LouisMalbranque/Table-Rotative/Réunion du 25 03.docx

Réunion du 25/03 :

Objectifs de la semaine :

Val et Louis :

- Connexion Appli au HC05 ou à l’ESP
- Balancer une trame correcte sans design
- Avancer sur le design

Nous :

- Connecter l’ESP à la place de l’arduino sur le boitier de commande / moteur
- Connexion ESP/ESP
- Envoie le PCB moteur avec la modif ESP
- Vérifier l’optocoupleur ça permet de déclencher : PCB

PCB :

Idée : si on utilise le même PCB pr dvp le projet : récupérer les connecteurs non branchés sur l’ESP et les mettre sur des connecteurs…

Appli :

Tentative de connexion tél -> HC05.
