LouisMalbranque/Table-Rotative/Liste Matériel.docx

Liste Matériel :

- Breadboard
- Ecran LCD
- 1 abaisseur de tension
- 1 NRF
- 1 module Bluetooth
- Relais KY019
- 1 arduino uno + cable
