LouisMalbranque/Table-Rotative/Rapport.docx

Valentin Lupa

Louis Malbranque

Guillaume Vacheron

Alexia Verpoort

Projet M1 S2 :

Amélioration d’une Table Rotative

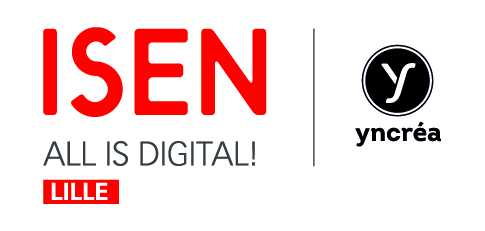
[picture p1: figure]

# Remerciements

Nous souhaitons remercier Nicolas Lissarague, commanditaire du projet, pour ses réponses à nos questions et son aiguillage au cours de ce projet. Et également pour son encadrement tout au long des six semaines.

Enfin, nous remercions Christophe Denoyelle pour la gestion des commandes, et la gestion de la création des PCB.

# Sommaire

# Introduction

Ce projet est une continuation du projet du premier semestre. Monsieur Lissarague avait besoin de finaliser la conception hardware du projet mais il souhaitait également une application mobile pouvant contrôler son projet. Le groupe a été modifié en fonction des volontés de projet du groupe initial. Deux nouveaux membres ont été intégrés au groupe, Louis Malbranque et Guillaume Vacheron, tous deux intéressés par l’aspect très pratique et très utile du projet, le but étant d’avoir un produit fini pouvant être fonctionnel et reproductible.

Le but du projet initial proposé notamment au premier semestre était d’améliorer un système permettant la rotation d’une table sur laquelle repose un objet destiné à la photogrammétrie. Cet objet doit être pris en photo selon plusieurs angles en fonction des arrêts de la table afin de pouvoir par la suite produire une modélisation en 3D de l’objet.

L’objectif principal du projet était donc d’obtenir une table rotative entièrement fonctionnelle dont l’action sur le moteur était commandée directement par une application Android. Il fallait également corriger les problèmes techniques pouvant survenir lors du déroulement et donner des versions finalisées d’un PCB. Ce projet avait donc une priorité sur le résultat.

# Système de base

Le système sur lequel nous avons travaillé est la continuité d’un projet mené au premier semestre : avant d’aborder les différentes améliorations au système, nous allons commencer par expliquer notre base de départ.

NRF24

Appareils photo

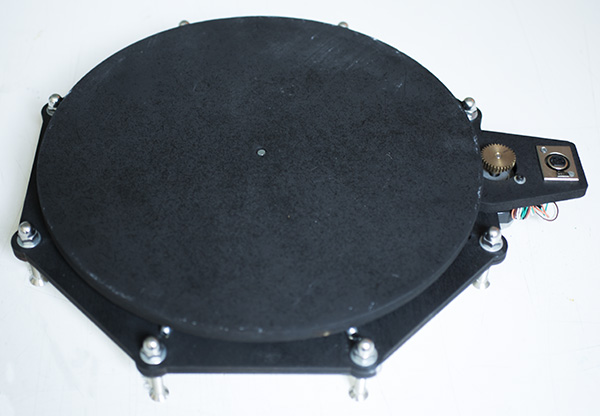
[picture p2: figure]
montage table rotative final
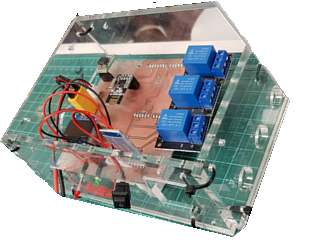
[picture p3: figure]

Communication radio par NRF

[Accélération, Vitesse, Frame,

Steps, Degré, Pause]

PCB moteur

+ moteur

HC05

Relais

LCD

Communication BT par hc05

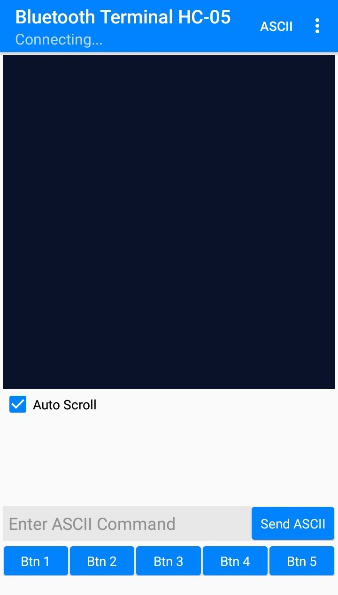
[picture p4: figure]

Accélération, Vitesse, Frame,

Steps, Degré, Pause

Représentation du système de base

Nous sommes donc partis d’un système qui était découpé en 2 parties, une partie boitier de commandes, transmettant les informations aux différents périphériques que ce soit la table elle-même ou les appareils photos, et une partie moteur permettant la réception des données et le contrôle d’un driver moteur sur un moteur pas à pas. Les 2 parties distinctes imposant notamment la présence d’un câble entre le moteur et le boitier de commande.

Au niveau du hardware, chacune des deux parties étaient contrôlées par un Arduino (uno ou nano) et les deux parties pouvaient communiquer entre elles par le biais du module NRF24 par ondes radio. La partie boitier de commande recevait des informations d’une application bluetooth serial communiquant sur le port série de l’Arduino. L’utilisateur transmettait les informations suivantes : l‘accélération voulue pour la rotation du moteur, la vitesse, le nombre de photos à prendre, le nombre de pas moteur, le degré désiré et la durée d’une pause de moteur. Ces données étaient envoyées par bloc et séparées par une virgule. Elles étaient ensuite affichées sur le LCD puis transférée au bloc moteur. Le bloc moteur réalisait alors ses rotations et à chaque pause, renvoyait un signal au bloc commande pour que celui-ci active ses 3 relais en même temps qui permettent de déclencher les appareils photos.

Au niveau du fonctionnement, un seul des 3 relais s’activait, un PCB sur deux était fonctionnel, et le boitier de commande manquait parfois un message du moteur, ce qui empêchait le moteur de s’arrêter définitivement après un tour complet.

# I/ Gestion du projet

Au départ du projet, un échange de mails avait permis d’identifier les premières tâches attendues par Monsieur Lissarague et avait permis de commencer à réfléchir de notre côté sur les potentielles options pouvant être ajoutées. Pour des raisons de méthodologie et d’efficience, le groupe de 4 s’est scindé en deux. Une réunion avait été programmée le lundi 18 mars au matin avec Monsieur Lissarague afin de connaitre ses objectifs ainsi que pour discuter les différents points d’amélioration que nous envisagions.

A la fin de la réunion, en fonction des premiers objectifs donnés, les priorités suivantes ont été déterminées :

F0 (objectifs incontournables) :

- Création d’une application fonctionnelle gérant la connexion par Bluetooth, l’envoi des données par paramétrages et l’envoi des données en temps réel. La différence entre les deux modes étant que le paramétrage ressemble à ce qui existait précédemment avec une rotation dont les pauses dépendent du nombre de photos, et le temps réel étant un mode continu, sans pause, dont la durée dépend de ce que souhaite l’utilisateur.
- Adaptation du code précédent pour pouvoir gérer le temps réel et le paramétrage. (Avant il y avait uniquement le paramétrage).
- Réglage de tous les précédents problèmes de synchronisation pour avoir une table entièrement fonctionnelle.
- Faire des PCB si possible en Chine.

F1 (objectifs nécessaires) :

- Gérer un NEMA23 pour remplacer le précédent moteur qui était un NEMA17 et ainsi permettre l’utilisation de la table pour des objets plus lourds.
- Revoir les composants : remplacer l’arduino par un ESP32 et les relais par des transistors.
- Augmenter le nombre d’appareils photos possibles et ajouter un délai entre le déclenchement de chaque appareil.
- Rajouter des paramètres variables en fonction de la taille du moteur et de la taille de la table afin de connaitre le nombre de pas nécessaires au moteur pour que la table réalise un tour entier.

F2 (objectifs souhaitables) :

- Fonctionnalité magnétoscope c’est-à-dire un déplacement entièrement manuel se présentant sous la forme de plusieurs boutons : avance, recul, avance rapide, recul rapide.
- Réfléchir à un déclenchement infrarouge des appareils photo permettant de ne pas avoir de câbles jack qui relient les appareils photos au boitier de commande.

La réflexion autour de ces différents objectifs nous a alors permis d’élaborer un planning de travail pour les 3 premières semaines, afin de s’assurer de respecter les objectifs initiaux avant de commencer la recherche d’améliorations annexes.

| 18 /03 | 19/03 | 20/03 | 21/03 | 22/03 | 25/03 | 26/03 | 27/03 | 28/03 | 29/03 | 1/04 | 2/04 | 3/04 | 4/04 | 5/04
Modifier le code en orienté objet boitier
Modifier le code en orienté objet du plateau
Application android
Se connecter en Bluetooth avec Android Studio
Mode programmé
Mode temps réel

Planning Binôme Louis/Valentin

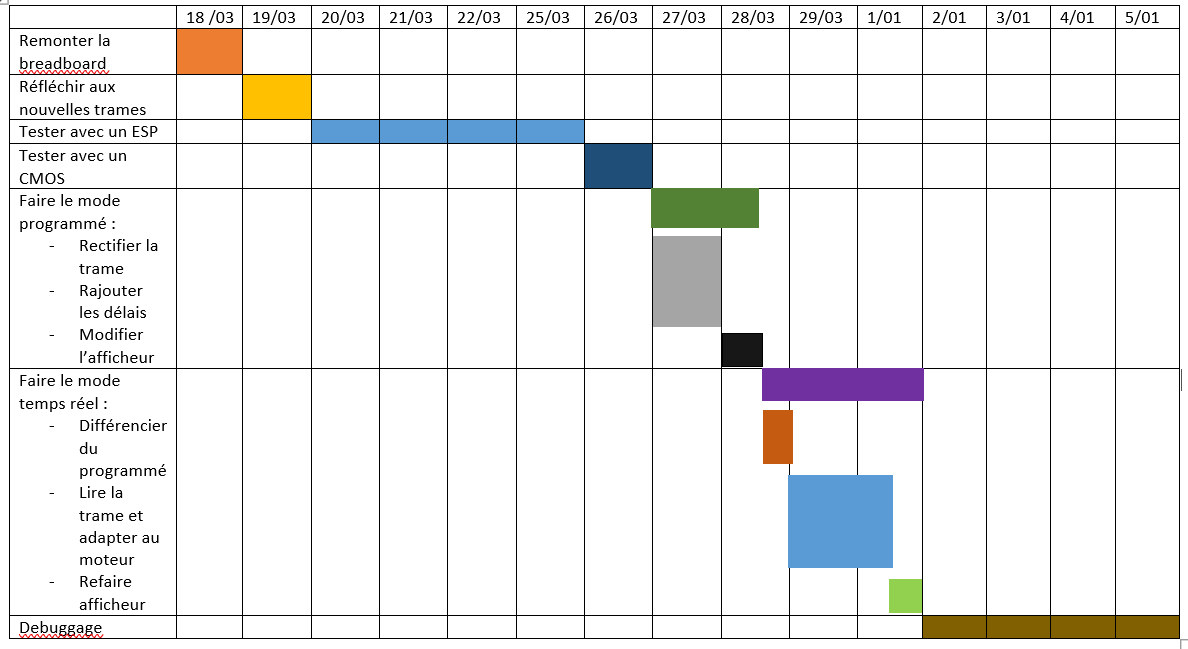
[picture p5: figure]

Planning Binôme Guillaume/Alexia

Cette première esquisse de planning, nous a permis de gérer notre temps au début du projet, nous avons choisi de ne pas se positionner sur les 3 dernières semaines puisque les délais estimés pouvaient être arbitraires, et que les ambitions de fin de projet pouvaient évoluer.

Le planning a été utile pour l’organisation, mais les délais affichés étaient en règle générale assez long, ce qui nous a permis de réfléchir à de potentielles améliorations plus poussées que ce qui était prévu et d’ajouter de nouvelles fonctionnalités suite aux nouvelles discussions avec Monsieur Lissarague.

Concernant l’organisation des réunions et la communication, nous avons choisi de faire un point assez régulier sur les avancées de chacun tous les deux jours, sans oublier l’utilisation des réseaux pour se maintenir au courant en temps réel. La charge de travail pouvait ainsi être répartie plus facilement, afin d’éviter qu’un binôme ou une personne n’ait trop d’objectifs à réaliser en parallèle alors que l’autre binôme avait terminé les siens.

Nous avons également organisé différentes réunions skype avec Monsieur Lissarague, ainsi qu’organisé une réunion physique de mi-projet pour lui faire part de nos avancées et lui faire une démonstration de ce qui était fonctionnel. Cette réunion nous a notamment permis de trouver de nouvelles idées telles que le focus stacking qui sera décrit plus bas. Enfin, les échanges de mail nous ont permis de nous organiser, mais également de clarifier certains points.

# II/ Amélioration de la partie hardware

(SCHEMA BLOC ET SCHEMA ALIMENTATION RAPPORT PREMIER SEMESTRE A REFAIRE)

1) Réflexion autour de l’utilisation d’ESP32 et des transistors

Lors de la première réunion avec Monsieur Lissarague, nous lui avons émis l’idée d’apporter une amélioration supplémentaire au projet afin de supprimer les anciens problèmes de synchronisation qui avaient pu exister au semestre 1. Nous voulions également passer sur microcontrôleur. Afin de maintenir l’accessibilité au code, qui était programmé par l’IDE arduino, et également de simplifier le Hardware, nous avons fait le choix d’utiliser un module de Développement ESP32. L’ESP32 étant un microcontrôleur programmable sous Arduino, le code reste compréhensible pour un habitué des arduino Uno et Nano. L’amélioration majeure apportée par les ESP32 consiste principalement dans l’existence d’une connexion Bluetooth directement intégrée. Notre objectif avec les ESP32 est donc de supprimer les HC05 précédemment présents et également généraliser toute la connexion en mode Bluetooth plutôt que d’avoir un mélange entre connexion par NRF (radio) et HC05.

Afin de gérer la nouvelle connexion, nous avons commencé par adapter la connexion entre une application Android. Le fonctionnement reste identique au HC05, mis à part le nom de la bibliothèque utilisée, les fonctions ayant, elles le même nom, et la logique du code pour obtenir le message ne changeant pas. On a donc une communication Bluetooth qui s’effectue directement sur le Port Série de l’ESP32, le tout étant récupéré caractère par caractère. Le traitement de l’information étant ensuite réalisée en fonction de la trame, il fonctionne en suivant un découpage selon les virgules puis une attribution à chaque variable permettant de contrôler le plateau. Cette étape nous a ainsi permis de supprimer le HC05.

Nous nous sommes ensuite penchés sur le NRF, l’ESP32 et l’utilisation du NRF n’était pas évidente. Premièrement, d’un ESP à l’autre, l’emplacement des Pins permettant la communication, qui est réalisée par SPI, peut varier. Il est ensuite difficile de percevoir l’origine d’une erreur lors de l’utilisation d’un NRF et ceux-ci étant très fragiles, ils peuvent être grillés sans que nous le sachions. Nous avons donc décidé, pour rendre la communication plus homogène et pour utiliser le Bluetooth interne de réaliser une connexion Bluetooth entre les deux ESP32, ce qui permet notamment une meilleure synchronisation.

Nous avons d’abord testé une connexion Bluetooth comme celle qui existe entre un ESP32 et une application Android. Nous nous sommes alors heurtés à un problème qui est que l’ESP32 est considéré comme un module esclave. C’est-à-dire qu’il ne peut pas faire le choix de s’appairer à un autre module Bluetooth mais doit attendre un ordre pour cela. Il n’est donc pas possible, avec le Bluetooth passant par le port série, d’appairer les deux ESP32 car il n’y a pas d’ordre d’appairage envoyé.

Afin de pallier ce problème, nous nous sommes penchés sur une connexion BLE (Bluetooth Low Energy) entre ces deux ESP32. Cette connexion est composée d’un serveur (l’esclave) et d’un client (le maitre). Afin de réaliser cette connexion, nous nous sommes d’abord penchés sur la manière dont les informations pouvaient transiter entre client et serveur. Après quelques recherches, nous avons identifié que le serveur hébergeait en réalité des caractéristiques, qui peuvent prendre la forme d’un string (chaine de caractères) qui lui sont accessibles. La particularité de la communication BLE est que le client, selon l’initialisation du serveur, peut lire ou écrire dans ces caractéristiques.

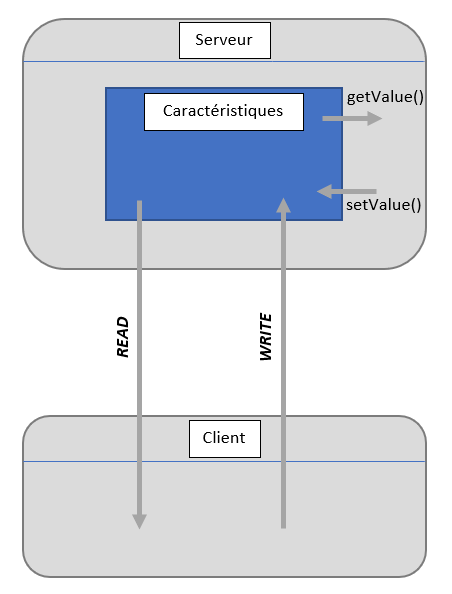
[picture p6: figure]

Nous avons donc adapté ce mode de fonctionnement à notre problème. Plutôt que d’envoyer un tableau de données comme c’était précédemment le cas dans notre NRF, nous avons fait transiter les données à travers la lecture et écriture des caractéristiques du serveur. Le boitier de commande a été programmé comme le maitre, puisque c’est seulement lorsqu’il reçoit une trame de l’application qu’il peut ensuite les transmettre au moteur. Le serveur est donc le plateau. Lorsque le boitier veut transmettre des données, il les écrit directement dans ses caractéristiques, s’il identifie qu’elles ont changé, il peut réaliser un déplacement. Pendant ce temps, le client lit en permanence les caractéristiques pour y apercevoir un signal de fin de déplacement pour déclencher les appareils photos.

Une fois ce mode de communication fonctionnel, nous avons regroupé les deux modes de communications Bluetooth : le programme étant linéaire, l’association des deux n’a pas posé de problème.

Le second changement majeur au niveau du hardware a été le remplacement des relais. Ceux-ci étant trop volumineux, et produisant un bruit à chaque activation, nous avons fait le choix de proposer une nouvelle configuration pour le déclenchement des appareils photo. En premier lieu, nous avons réfléchis à la possibilité de remplacer les relais par des transistors qui est un composant contrôlant le courant ou la tension de sortie en fonction d’une tension qu’on lui applique et qui peut donc être bloquant ou passant.

Après quelques recherches, il nous semblait risqué d’utiliser les transistors pour les appareils photo, nous nous sommes alors orientés vers les optocoupleurs qui sont des composants qui fonctionnent sensiblement de la même manière, qui fournissent donc une tension de sortie en fonction d’une commande. Ces composants étant composé de deux circuits (l’entrée et la sortie) complétement isolés, cela permet de s’assurer qu’aucun courant ne viendra court-circuiter l’appareil photo.

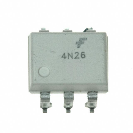
[picture p7: figure]

Nos optocoupleurs fonctionnent donc par intermittence grâce à une pin de commande, qui est mise à l’état haut lorsque l’on souhaite activer un appareil photo, l’optocoupleur est donc capable de fournir une tension de sortie permettant la prise de vue, puis lorsque le pin est remis à l’état bas, l’optocoupleur est de nouveau bloqué et se comporte comme un interrupteur ouvert.

Prise de photo

Pin à 1

Attente

Pin à 0

2) Concept de Focus Stacking

Au vu de l’avancée du projet, il nous a été proposé d’ajouter une nouvelle fonctionnalité au projet : le focus stacking. Ce nouvel élément concerne principalement le déclenchement des appareils photos. Il s’agit d’un mode de fonctionnement qui permet à l’utilisateur de prendre plusieurs photos avec le même appareil photo en modifiant la mise au point entre chaque élément.

Ce qui nous a été proposé est de modifier un système existant permettant grâce à un moteur de pivoter la bague de mise en point afin que le moteur soit commandé par le boitier de commande et que la mise au point à chaque prise de vue se fasse automatiquement. Le fonctionnement général serait donc qu’à chaque arrêt du moteur de la table, les appareils connectés se déclenchent comme précédemment mais qu’avant que la table ne recommence sa rotation, la mise au point soit réglée sur chaque appareil pour une nouvelle photo jusqu’au nombre de photo défini, puis que la mise au point soit remise à son origine pour reprendre la rotation de la table.

Pour cela, nous avons réutilisé le système présent pour le moteur de la table en insérant un ESP32, qui soit un serveur en Bluetooth, et qui pourrait donc recevoir les informations du boitier de commande pour actionner le moteur.

Après discussions, il a été déterminé que chaque appareil photo devait au préalablement pouvoir être réglé manuellement pour obtenir les mises au point voulues avec un maximum de 9 photos par appareil supplémentaire. Ce réglage permettant d’obtenir les différents pas nécessaires que le moteur doit réaliser entre chaque photo sur chaque appareil. Les données devaient ensuite être rentrées dans l’application pour que le boitier de commande puisse envoyer les ordres à chaque moteur d’appareil photo au moment voulu et pour toute la durée de la prise de vue. Ce réglage a été prévu pour être réalisé en pas à pas mais directement sur l’application, grâce à un magnétoscope permettant de faire avancer la bague petit à petit tout en permettant à l’application de calculer directement la valeur de mise au point idéale.

Nous avons pris la décision de déclencher les appareils photos et donc de les brancher directement sur ce module dans le cas où le focus stacking sera utilisé.

3) Modification de la trame d’envoi

Le système de base ne fonctionnait que selon un mode précis qui consistait à prendre un nombre de photos défini durant un tour. Au cours de la présentation des objectifs du projet par Monsieur Lissarague, celui-ci a émis l’idée d’ajouter différentes fonctionnalités et ainsi différents modes. La table rotative devait tout d’abord fonctionner comme lors du projet du premier semestre, c’est-à-dire programmer un nombre de photos à effectuer par un nombre d’appareils photos donnés durant un tour de plateau. Le second mode est en mode continu, la table doit tourner soit pendant un nombre de tours définis soit durant un temps défini. Enfin, une fonctionnalité sous forme de touches de magnétoscopes permettant de bouger comme l’utilisateur le souhaite grâce à des touches d’avance, de recul faisant tourner la table le temps de l’appui ou selon le nombre d’appui de l’utilisateur. Il nous a également fallu ajouter le focus-stacking au fonctionnement de base.

A) Communication Téléphone-Boitier de Commande

Afin de pouvoir intégrer plus facilement les fonctionnalités, un travail sur les trames d’envoi ont été réalisées ainsi que sur les communications. Plusieurs solutions ont été envisagées afin de faciliter la distinction entre modes et également de rendre le code plus ouvert à l’intégration de nouveaux modes.

Au niveau de la communication, nous sommes restés sur un système de trame avec les différentes valeurs séparées par des virgules. Il existe différents MODE qui permettent au boitier de commande s’identifier les différentes trames :

MODE | Utilisation | Explication rapide
0 | Mode programmé | Permet d’effectuer un déplacement sur un tour en réalisant des pauses selon le nombre de photo défini
1 | Mode temps réel | Permet d’effectuer une rotation en fonction d’un nombre de tours ou en temps
3 | Pause | Permet de mettre en pause une action
4 | Arrêt complet | Permet d’arrêter totalement le fonctionnement
5 | Magnéto focus_stacking | Permet de régler le focus en déplaçant le moteur collé à la bague du focus et de retenir les valeurs choisies par l’utilisateur
7 | Connexion aux périphériques | Permet de sélectionner des périphériques avec lequel le boitier de commande va interagir
8 | Paramétrages focus_stacking | Permet d’envoyer les données de tous les appareils photos après réglage grâce au mode 5 pour réaliser une prise de vue avec focus_stacking

Nous allons surtout nous attarder sur les modes 0 et 1 qui sont au cœur de l’utilisation de la table rotative. Pour éviter tout problème de décodage au niveau du boitier de commande, le schéma de la trame envoyé est donc identique en mode temps réel (ou continu) et programmé. L’un des éléments de la trame permet de distinguer si l’on est dans tel ou tel mode.

ID_COMMANDE, MODE, ACCELERATION, VITESSE, NOMBRE_DE_PAS_TABLE, DIRECTION, CHOIX_ROTATION, NOMBRE_DE_TOUR, TEMPS_DE_ROTATION, NOMBRE_DE_PHOTOS, NOMBRE_DE_CAMERAS, PAUSE_ENTRE_CAMERAS, FOCUS_STACKING

Accélération, Vitesse, Nombre_Photos, Nb_Pas_Table, Degré_Désiré, Durée_Pause

Comparaison entre l’ancienne trame et la nouvelle trame

Lors de la récupération de la trame par l’ESP32, tous les éléments de la trame sont récupérés sous forme de String (chaine de caractère) comme représentée ci-dessus. Les éléments sont ensuite récupérés grâce à un découpage selon la virgule et stockés dans un tableau de valeurs. Les valeurs sont ensuite interprétées selon le mode.

La trame est composée des éléments suivants :

-ID_COMMANDE : ID qui est généré automatiquement dans l’application afin de pouvoir différencier plusieurs envois de rotation différents

-MODE : Différence entre les modes pour savoir si l’on est en mode Programmé et Temps Réel

-ACCELERATION, VITESSE : correspondent à la vitesse de la table pendant une rotation et de remise en route après un arrêt.

-NOMBRE_DE_PAS_TABLE correspond au nombre de pas nécessaire pour le moteur pour que la table rotative réalise un tour complet.

-CHOIX_ROTATION : permet de faire une distinction entre le NOMBRE_DE_TOUR et le TEMPS_ROTATION.

-NOMBRE_DE_CAMERAS correspond au nombre de caméras utilisées pour la prise de vue avec un maximum de 9 caméras se déclenchant successivement selon la valeur de PAUSE_ENTRE_CAMERAS durant un arrêt moteur. Le NOMBRE_DE_PHOTOS correspond au nombre de prise de vue (indépendant du nombre d’appareil) au cours d’un tour.

-FOCUS_STACKING : Le nombre de prises de vues avec niveau de focus différents par appareil photo et par arrêt. Il est égal à 0 lorsque le focus_stacking n’est pas désiré.

Lors de la réception des informations par l’application, le boitier de commande crée une liste d’instructions, qui regroupe toutes les instructions qui vont être envoyées aux différents périphériques pour effectuer l’action requise par l’application. La liste d’instruction comporte donc tous les envois de rotation, les prises de photo et permet donc d’avoir une séquence préparée avant toute communication. Chaque instruction ayant un ID spécifique.

B) Communication Boitier de commande-Moteur/périphériques externes

La liste d’instruction ayant été créée, le boitier peut alors communiquer avec les différents périphériques.

Lorsque le boitier de commande a récupéré et décodé la trame (selon le type de MODE 0 ou 1) comme décrit dans le paragraphe précédent, le boitier de commande communique au moteur afin que celui-ci réalise le déplacement souhaité, il peut aussi réaliser les différents réglages nécessaires au focus stacking (décrit en détail dans la partie mode programmé). Nous allons commencer par aborder l’échange uniquement avec le moteur.

La communication se fait par le biais de la communication BLE déjà explicitée. Chaque côté peut lire et écrire dans les caractéristiques du serveur BLE qui est le moteur.

Lorsque le moteur n’effectue aucune action, sa caractéristique est à 0, ce qui permet au boitier de commande de savoir que ce dernier est libre et peut recevoir de nouvelles instructions. En fonction du paramètre MODE reçu par le boitier de commande, deux cas se distinguent dans l’envoi du datagramme :

- Cas Mode temps Réel (MODE à 1)

Dans le cas du temps réel, seuls les paramètres : Accélération, Vitesse, Nombre_de_pas_table, Direction, Choix_Rotation, Nombre_De_Tour et Temps_Rotation, sont utilisées.

L’élément Choix_rotation permet de comprendre si l’utilisateur souhaite réaliser une rotation en continu selon le nombre de tours souhaité (dans ce cas Temps_Rotation ne servira pas) ou selon une durée précise. Il est inutile de préciser le nombre d’appareils photos puisque ce mode est destiné à une prise de vue par caméra par exemple.

Lorsque ce mode est sélectionné, le datagramme écrit dans les caractéristiques du moteur est la suivante :

CHOIX_ROTATION = 0

ACCELERATION, VITESSE, DIRECTION, CHOIX_ROTATION, NOMBRE_DE_TOUR

OU

CHOIX_ROTATION = 1

ACCELERATION, VITESSE, DIRECTION, CHOIX_ROTATION, TEMPS_ROTATION

Les valeurs envoyées TEMPS_ROTATION et NOMBRE_DE_TOUR étant quelque peu modifiées pour permettre d’envoyer une valeur utilisable telle qu’elle par le moteur. Ainsi le TEMPS_ROTATION est multiplié par 1000 pour correspondre à un temps en secondes (auparavant millisecondes) et NOMBRE_DE_TOUR est multiplié par le nombre de pas total de la table.

- Cas Mode Programmé (MODE à 0)

Dans ce pragraphe nous allons aborder la communication du boitier de commande suite à la réception d’un mode 0 mais également aborder les modes 5 et 7 qui peuvent être des antécédents à la réception d’un mode 0 si l’on souhaite effectuer du focus stacking

a) Déplacement du moteur

Dans le cas du mode Programmé, seuls les éléments Accélération, Vitesse, Nombre

De pas table, Direction, Nombre_De_Photos, Nombre_De_Caméras, Pause_entre_Camera sont utilisés.

Lorsque ce mode est sélectionné, la trame envoyée au moteur par bluetooth est la suivante :

ACCELERATION, VITESSE, DIRECTION, 0, NOMBRE_DE_PAS

Ce datagramme ne diffère pas beaucoup de celui du temps réel. Il s’agit en réalité d’un cas particulier dans lequel CHOIX_ROTATION = 0. Ce qui explique la 4ème valeur qui permet de forcer la lecture par le moteur d’un cas de rotation en fonction d’un nombre de pas à effectuer.

Concernant le nouveau paramètre NOMBRE_DE_PAS, celui-ci est un calcul entre le nombre de photos et le nombre de pas total pour effectuer un tour complet de la table. Il s’agit donc du nombre de pas entre chaque déclenchement.

b) Action sur les périphériques – application au focus_stacking

Le boitier de commande ne communique pas uniquement avec le moteur, il peut également communiquer avec les appareils photo ou les mécanismes de focus_stacking définis par l’utilisateur et envoyé grâce au mode 7 dans la communication Application-Boitier de commande.

Ces périphériques ne sont actionnés que dans le cas du mode programmé. Concernant les appareils photo, lorsque le boitier de commande identifie la fin d’une rotation du moteur, il déclenche les appareils photo. Le déclenchement des appareils photo a été géré comme si les optocoupleurs étaient eux-mêmes des périphériques bluetooth afin de garder de la cohérence. On fonctionne donc grâce à un système de thread (ou fil d’exécution) qui est la ligne de conduite du programme et deux threads peuvent être en parallèle donc l’esp32 peut gérer deux processus en même temps. Le processus principal envoie donc au processus secondaire une chaine commune dont le fonctionnement est identique aux caractéristiques d’un serveur BLE.

Prise de photo

Mise à 1 optocoupleur sur le boitier de commande

Nb photos

Boitier de commande

Moteur

Arrêté

Autant de déclenchement successif pour des optocoupleurs différents que de photos voulues

Représentation simplifiée d’une prise de photo sans focus stacking

Le déclenchement des appareils photo par rapport à une configuration en focus stacking se fait directement sur le module du focus stacking et nécessite de s’attarder sur les modes 5 et 7 qui sont reçus par le boitier de commande avec le mode 0. Tout d’abord le boitier recevra une trame décrite de la manière suivante :

ID_COMMANDE, 5, ACCELERATION, VITESSE, STEPS,DIRECTION, 0,NOMBRE_DE_PAS, -1,-1,-1,0,NUMERO_CAMERA

Les chiffres déjà définis étant pour garder une trame ressemblant aux précédentes

tout en bloquant certaines variables car elles n’ont pas d’utilité ici ou doivent être fixes (5 pour le mode par exemple). Les éléments importants étant la direction, le nombre de pas et numero_camera. Lorsque le boitier de commande reçoit ceci, il communique avec la caméra correspondant à Numero_camera. La valeur Nombre_De_Pas dépend en réalité d’une commande magnétoscope qui avance d’un certain nombre de pas dans telle ou telle direction et qui permet donc au moteur du focus stacking de se déplacer. Le boitier de commande communique donc le déplacement à effectuer si le moteur a ses caractéristiques à « 0 » et qu’il est donc libre. Cela permet à l’utilisateur de connaitre le nombre de pas de la bague de focus entre chaque photo qu’il souhaite réaliser sur un même appareil. Ces valeurs étant stockées dans l’application avec un maximum de 8 valeurs stockées par appareil. Ce datagramme est envoyé autant de fois que d’appui sur les touches magnétoscope pour un appareil donné.

A la fin de tout réglage, avant la réception du mode 0, le boitier recevra autant de datagramme mode 8 que d’appareils concernés par le focus stacking. Ce datagramme reçu est de la forme suivante :

ID_COMMANDE, 8, Numero_Camera, param0…param7

Il y aura entre 1 et 8 valeurs param qui correspondront aux valeurs de rotation du moteur du focus_stacking retenue par l’utilisateur pour avoir les mises au point requises. Lorsque le moteur de la table est arrêté, le boitier de commande envoie à chaque module nécessitant le focus stacking, le nombre de photo à réaliser et le nombre de pas moteur que le moteur du focus doit faire entre chaque photo.

Pas souhaité

ESP32 sur l’appareil photo

Nb photos

Différents pas

Boitier de commande

Rotation

Moteur

Prise de photo

Moteur

Arrêté

Réalisé autant de fois que de photos

Représentation simplifiée d’une prise de photo par focus stacking

On a donc un déclenchement des appareils branchés sur le boitier de commande ne fonctionnant pas par focus stacking et des appareils photos déclenchés directement par l’ESP32 relié à la bague d’un focus où les appareils photo sont branchés sur ce PCB correspondant.

- Généralités

Indépendamment du mode, une fois l’action reçue les caractéristiques du moteur ou des périphériques (appareils photo ou focus stacking) sont mises à « 1 » par le périphérique pour que le boitier de commande sache qu’il n’est pas disponible. Une fois la rotation effectuée ou la prise de vue effectuée, le périphérique se met ses caractéristiques à « 2 » pour que le boitier de commande comprenne qu’une instruction a été terminée. Celui-ci se charge alors de remettre les caractéristiques à « 0 » et de continuer sa liste d’instruction. Il est important de comprendre que dans le cas du mode programmé, il y aura autant d’envoi de datagramme que de photos à prendre (le moteur ne fait pas de pause, il attend en réalité un nouvel ordre), tandis qu’en mode programmé il n’y aura qu’un envoi unique.

Le moteur peut également avoir ses caractéristiques correspondant au chiffre « 3 », ce qui signifie que le boitier de commande lui envoie une pause dans son fonctionnement.

Légende :

Ecriture par boitier de commande

Ecriture par périphérique

Lecture par Boitier de commande

Lecture par périphérique

Boitier de commande

Réalisation tâche

Périphérique

Caractéristique à 1

Périphérique

Caractéristique égale à la trame

Périphérique

Caractéristique à 0

Tâche terminée

Périphérique

Caractéristique à 2

Boitier de commande

Légende :

Ecriture par boitier de commande

Ecriture par périphérique

Lecture par Boitier de commande

Lecture par périphérique

Représentation simplifiée de la réalisation d’une tâche par un périphérique

C) Communication Boitier de commande-Téléphone

Afin de permettre à l’utilisateur d’avoir une vue sur les actions en cours, un feedback

a été créé entre le boitier de commande et l’application.

Trois types de datagrammes ont été créés. Le premier informe l’application qu’une instruction a été créée pour un périphérique. Cette étape a lieu avant tout envoi d’instruction aux périphériques, et permet à l’utilisateur de connaitre toutes les actions qui vont être réalisées. Il lui renvoie alors un datagramme composé :

- De la chaine de caractère « création »
- D’un ID_COMMANDE : représente l’identifiant de la commande concernée, ID commande précédemment créée par l’application et envoyée au boitier.
- -D’un ID_instruction ; représente l’identification de l’instruction créée (prise de photo, demande de rotation moteur) présente dans la liste d’instruction de la commande créée lors de la réception.
- Du nom du périphérique concerné (moteur par exemple)
- Le datagramme qui sera transmis au périphérique

Le second type de datagramme permet au boitier de commande de communiquer le

Démarrage de l’instruction. Cela permet notamment à l’utilisateur de savoir où en est la table rotative dans sa liste d’instruction (par exemple : première prise de photo en cours). Cela permet donc d’avoir une vision en temps réel. Le datagramme envoyé à l’application est le suivant :

- Chaine de caractère « en cours »
- ID_commande
- ID_instruction : correspond à l’ID de l’instruction qui vient de démarrer

Enfin le boitier de commande permet d’annoncer la fin d’une instruction, afin de pouvoir clore et afficher à l’utilisateur que l’instruction est terminée, la suite logique étant qu’un datagramme en cours pour l’instruction suivante sera envoyée.

3) Réécriture du code

Afin de rendre le code plus accessible et modifiable dans le futur, nous avons cherché à modifier la structure du code.

Tout d’abord, le code a été structuré selon différentes library qui sont en fait des fichiers regroupant différentes fonctions principales afin de simplifier le fichier principal. Ainsi, notre code fait appel à ces différentes library et donc aux différentes fonctions dans le code principal sans nécessité de coder plusieurs fois la même chose et également pour simplifier la lecture du code à un autre programmeur.

A titre d’exemple, pour communiquer avec un LCD, il faut l’initialiser, afficher sur l’écran, ou encore créer différents symboles à afficher. Une library LCD contient un fichier .h avec toutes les entêtes des noms de fonctions et un .cpp qui contient le code de chacune des fonctions. Donc on aurait une fonction initialiser, afficher, créer_symbole_bluetooth. Il suffit alors simplement de créer un objet dans le code principal de type LCD et d’utiliser les fonctions grâce à la synthaxe : nomObjet.fonction.

4) Adaptation du PCB et du boitier de commande

Un des objectifs principaux du projet était d’obtenir des PCB fonctionnels. Lors du premier semestre, seul l’un sur les deux fonctionnait en situation réelle. Nous avons donc mis l’accent sur la conception rapide des composants et des PCB sur Altium, tout en menant nos recherches pour les améliorations à apporter, tels que les ESP32 et les optocoupleurs.

Pour chacune des parties, un schéma hardware a été réalisé, permettant d’identifier facilement la manière de refaire nos connexions, puisqu’il faut le rappeler le but de Monsieur Lissarague est de fournir un projet accessible et modifiable. Ces schémas nous ont également aidé à réaliser les différentes schématiques.

Au niveau du PCB du boitier de commande, celui-ci ayant été réalisé très vite car nous partions d’une base fonctionnelle, nous avons fait le choix de garder au départ les relais et les optocoupleurs dans le cas où la nouvelle solution ne fonctionnerait pas. Le but étant de pouvoir gérer les problèmes de routage au plus vite pour envoyer les PCB en fabrication en Chine.

Les PCB ont pu être réalisés en Chine pour les PCB du moteur et de la table rotative, cependant 2 optocoupleurs ne peuvent pas être déclenchés au niveau du boitier de commande. L’un suite à un problème de schématique et l’autre en raison d’un pin de l’ESP32 ne pouvant être programmée en tant que sortie.

Les PCB du focus stacking en sont encore au stade de développement, l’option ayant été développée peu de temps avant le début du projet mais sont fonctionnels et permettent un bon fonctionnement de l’ESP32 et le déclenchement des appareils photo.

# III/ Application Android

1) Présentation Générale de l’application

Pour réaliser l’application, nous avons choisi de travailler sur Android Studio, à la suite de nos cours Android du Second Semestre.

Une application Android est composée de différentes activités qui représentent les différentes pages : connexion, envoi instructions etc… et qui ont chacune un layout, c’est-à-dire une mise en page spécifique, et une fonctionnalité.

Dans la suite de cette partie, nous aborderons également le concept de fragment, il s’agit en réalité d’une sorte de « collage » sur une activité, un fragment est un nouvel élément qui vient se positionner au-dessus de l’activité (avec son layout, ses fonctionnalités) et qui est utilisé par exemple pour des fenêtres pop-ups ou lors de l’ouverture d’un élément d’un menu par exemple pour garder le lien avec l’activité principale qui a permis l’ouverture de fragment.

Notre application se compose de deux grandes activités :

- La première est l’activité de connexion qui est donc une page qui permet de sélection le périphérique avec lequel on souhaite communiquer.
- La seconde activité gère tout le dialogue avec la table rotative, elle est donc composée de différents fragments, chaque fragment correspondant aux différents modes ou éléments nécessaires au bon fonctionnement. Il y a donc un fragment de sélection des périphériques avec lequel le boitier de commande devra communiquer, le mode temps réel, le mode programmé.

Dialogue

Connexion

Mode programmé

Mode temps réel

Base de données

Sélection

Représentation schématique de la structure de l’application

2) Communication Bluetooth grâce à l’application

La première chose réalisée sur l’application a été de communiquer directement avec un ESP32. Le but premier étant de parvenir à se connecter directement avec le boitier de commande pour réaliser la connexion série Bluetooth.

Lors d’une connexion Bluetooth, d’ordinaire, une liste des périphériques appareillable s’affichent pour sélectionner celui qui nous intéresse. Nous avons représenté le même système dans l’application. Une classe objet a été créée, c’est-à-dire une variable personnalisée contenant elle-même différentes variables et fonctions qui la caractérise. Cette classe représente un périphérique avec tous ses caractéristiques propres : son nom, adresse, s’il est connecté, les différents éléments permettant de s’y connecter. Les périphériques utilisent notamment des sockets pour la communication, qui permettent notamment une connexion durable sans nécessité d’envoyer l’adresse de destination à chaque envoi de données.

Lorsque la liste est récupérée, chaque élément est affiché suivant la mise en page suivante :

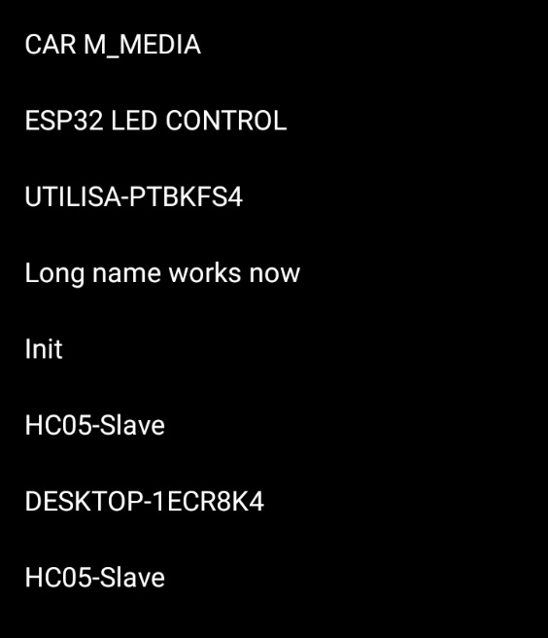
[picture p8: figure]

Exemple d’appareils appairé à un téléphone

Les éléments étant tous stockés dans une liste, chaque élément est affiché (une ligne équivaut à un élément) selon la mise en page qui a été définie et qui est ici de récupérer le nom de chaque objet de la liste et de l’afficher.

Il est possible de s’y connecter lors d’un appui sur un élément et en appuyant sur le bouton connecter

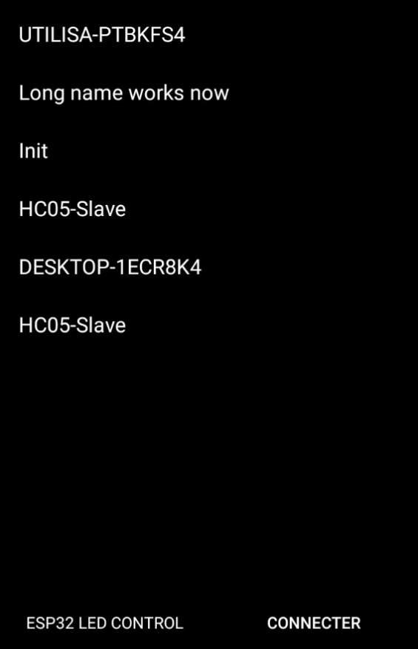
[picture p9: figure]
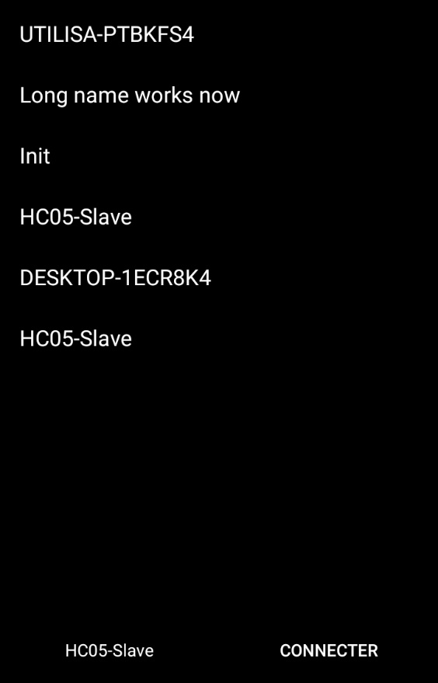
[picture p10: figure]

Boitier de commande

Boitier de commande

Boitier de commande

Les périphs sur l’appli sont donc une liste des périphériques appairés au préalable avec le téléphone.

Comme lorsque l’on souhaite se connecter au bluetooth d’une voiture, on va dans les réglages du téléphone et on se connecte au boitier de commande.

Une fois le boitier de commande appairé, on va pouvoir utiliser l’application en sélectionnant le périphérique souhaité et en s’y connectant

Un périph correspondant donc a un esp présent dans le boitier de commande. L’esp ayant un module bluetooth, il permet donc de se connecter au bluetooth du téléphone.

3) Envoi et récupération de données

Une fois la connexion réalisée, l’application est appairée avec un périphérique et peut donc lui communiquer des informations.

En raison du focus stacking, une première page de sélection de périphérique à été ajoutée, on parle ici des périphériques qui communiqueront avec le boitier de commande.

Cette page se présente sous la forme d’une liste contenant tous les éléments que l’utilisateur souhaite utiliser et commander par le boitier de commande. Il y a donc le moteur, la sélection des différentes caméra utilisée (leur numéro dépendant du branchement sur le PCB) et si le mécanisme du focus stacking a été ajouté et quelle caméra peut donc l’utiliser.

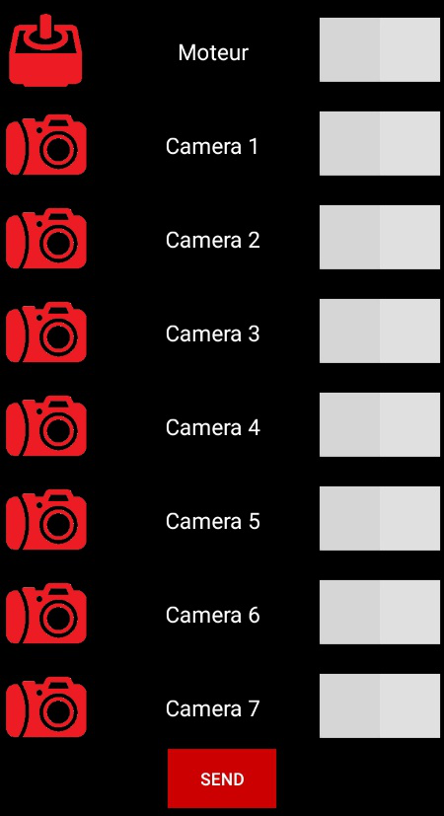
[picture p11: figure]

L’utilisateur peut ainsi sélectionner les périphériques grâce à un switch. La sélection des différents éléments permet alors à l’application d’envoyer un datagramme au boitier de commande composé de :

- « 0 » : ID de commande
- « 7 » : Mode de sélection périphérique
- Une succession de « 0 » ou « 1 » dépendante de l’état des switchs pour les différents périphériques de la liste précédente.

Lorsque l’utilisateur a sélectionné ses périphériques, une page de menu s’ouvre, qui permet

La sélection du mode qu’il soit temps réel ou programmé.

- Temps réel

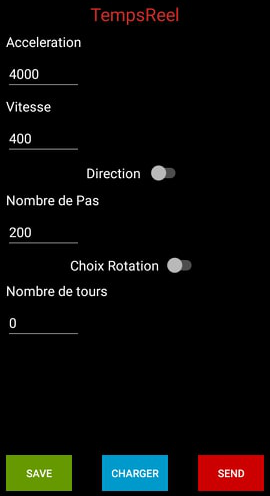
[picture p12: figure]
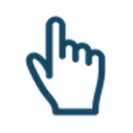
[picture p13: figure]
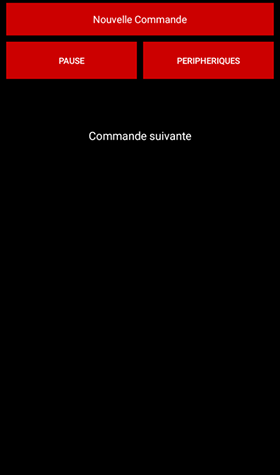
[picture p14: figure]

Sur le nouveau fragment de l’application, l’utilisateur peut sélectionner les paramètres qu’il souhaite modifier, certaines valeurs ayant été définies par défaut pour leur pertinence.

Un travail sur l’affichage a été réalisé afin de ne pas donner trop d’informations à l’utilisateur, ainsi lors d’un appui sur le switch choixRotation, l’utilisateur verra affiché une sélection nombreDeTours comme sur l’exemple ou durée, il saura ainsi quelle est le mode de fonctionnement choisi sans pouvoir commettre une erreur.

Lors d’un appui sur Send, l’application envoie au boitier de commande une trame composée de :

- Un ID de commande défini de manière unique pour pouvoir l’identifier
- « 1 » correspondant au mode temps réel
- Puis les différents paramètres existants dans la trame suivante : ACCELERATION, VITESSE, NOMBRE_DE_PAS_TABLE, DIRECTION, CHOIX_ROTATION, NOMBRE_DE_TOUR, TEMPS_DE_ROTATION, NOMBRE_DE_PHOTOS, NOMBRE_DE_CAMERAS, PAUSE_ENTRE_CAMERAS, FOCUS_STACKING.

Les paramètres n’existants pas en mode programmé étant mis à « -1 »

- Programmé

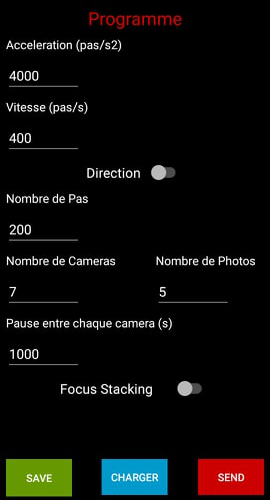
[picture p15: figure]

Une explication plus détaillée du fonctionnement sera expliquée dans la partie application du tuto.

Concernant la liste des commandes, une fois que la commande selon le mode a été envoyé au boiter de commande, on revient au menu où un résumé de la commande s’affichera avec les informations essentielles concernant le mode. Un bouton infos permettra également de savoir en temps réel où en sont les instructions du boitier de commande. En effet, une communication entre le boitier de commande et le téléphone permet d’avoir un feedback et ainsi de pouvoir suivre les instructions exécutées par le boitier de commande

4) Mise en place d’une Base De Données

Afin de rendre l’application plus ergonomique, une base de données a été mise en place pour permettre à l’utilisateur de sauvegarder certains modes de rotation sans être obligé de ressaisir les données.

Afin de différencier les deux modes de fonctionnement, deux BDD ont été créées, l’une contenant uniquement des données pour le mode programmé et l’autre uniquement des données temps_réel, ce qui ne pose pas de problème au niveau de l’implémentation car la réalisation est identique.

La réalisation d’une BDD implique la création de fichier “objets” qui déterminent quelles sont les informations qu’un élément de la BDD contient, un objet représentant, par exemple, toutes les informations nécessaires dans le cas d’un mode programmé. Ainsi, lors de l’ajout d’un élément dans la BDD, tous les champs sont récupérés et ajoutés dans l’objet adapté qui contient également des champs correspondants.

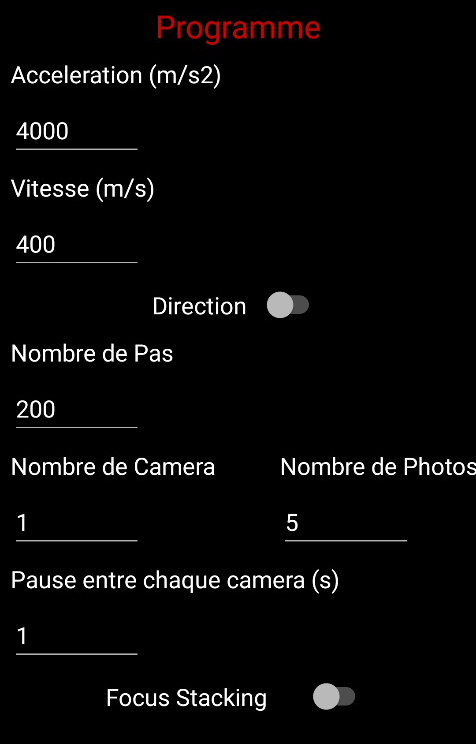
[picture p16: figure]

ID commande

Acceleration

Vitesse

Direction

NbPas

NbCamera

NbPhoto

PauseEntreChaqueCamera

Focus Stacking

Objet ValeurProgrammé

de la BDD

Champs utiles pour un envoi de

type Mode Programmé

Illustration de l’objet ValeurProgramme et de la récupération des données

Concernant l’ID de l’élément de la BDD, il était impossible de donner un nom par défaut directement dans le programme car les objets avec le même id s’écrasent. Nous avons donc mis en place un système de pop-up qui permet à l’utilisateur de choisir le nom qu’il souhaite. Sachant qu’il n’est pas possible d’ajouter plus de 10 éléments dans chacune des bases de données.

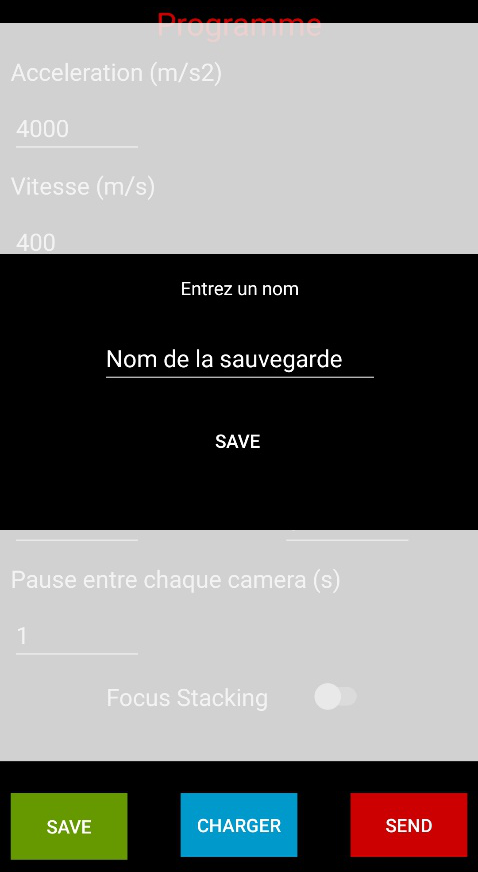
[picture p17: figure]
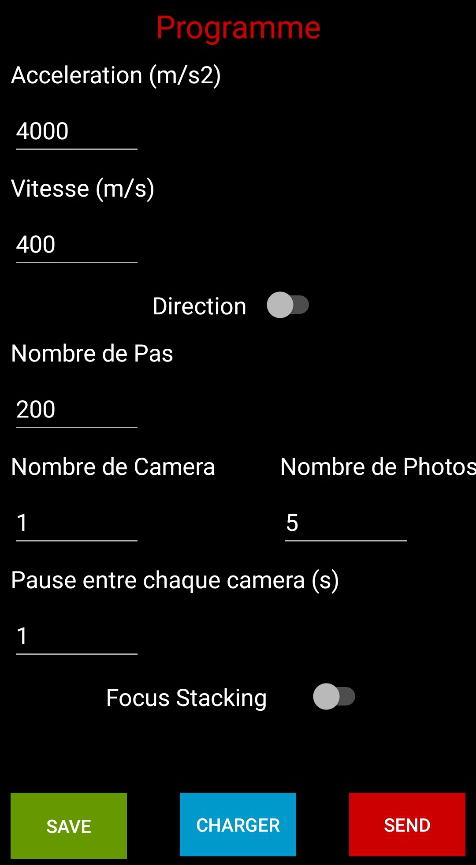
[picture p18: figure]

Enregistrement dans la Base De Données concernée

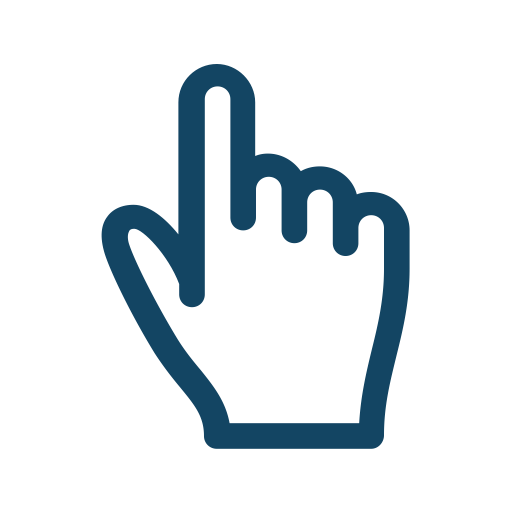
[picture p19: figure]

StoryBoard de l’enregistrement d’un élément de la BDD

La difficulté majeure d’une BDD réside dans l’appel des différentes fonctions. En effet, il est impossible de charger une BDD dans un code principal. Il faut passer par une tâche asynchrone qui permet de réaliser, par exemple, le chargement en tâche de fond. L’appel se fait donc dans le fragment dans lequel nous sommes situés, la tâche est ensuite réalisée en fond, et à la fin de la tâche, une fonction appelée postExecute est appelée, ce qui nous permet de faire le lien avec le fragment principal et garder une certaine logique. Cela permet de ne pas commencer à travailler sur les éléments d’une liste qui n’est pas encore créée dans la tâche de fond, par exemple.

L’utilité de la BDD étant de pouvoir sélectionner un élément déjà entré et sauvegardé, nous avons mis en place un système de chargement et d’affichage de tous les éléments. Les éléments sont alors chargés, un nouveau fragment est ouvert contenant un RecyclerView qui permet en réalité d’afficher tous les éléments de la liste en suivant une mise en page identique pour chaque élément. Une fois chaque élément affiché, il peut être sélectionné ou supprimé, le RecyclerView nous permettant de savoir exactement avec quel élément on interagit.

La suppression permet de supprimer l’élément directement dans la BDD, le fragment contenant la liste des éléments est alors fermé, pour éviter à l’utilisateur de pouvoir sélectionner un élément qui n’existe plus, ce qui permet à l’utilisateur de recharger la nouvelle BDD et ses changements.

La plus grande difficulté rencontrée lors de l’ajout de cette fonctionnalité concerne la sélection et le remplissage des champs dans le menu d’envoi en fonction de l’élément sélectionné. Finalement, nous avons considéré que lors d’un appui sur le bouton Sélection, les éléments de l’objet sélectionné sont sauvegardés, le fragment du menu pour l’envoi est ouvert, et ses éléments sont ajoutés en argument au début du code. La vérification de l’existence d’argument est donc vérifiée à chaque ouverture d’un menu d’envoi (le code ne faisant pas la différence entre une ouverture via le menu principal ou post-sélection).

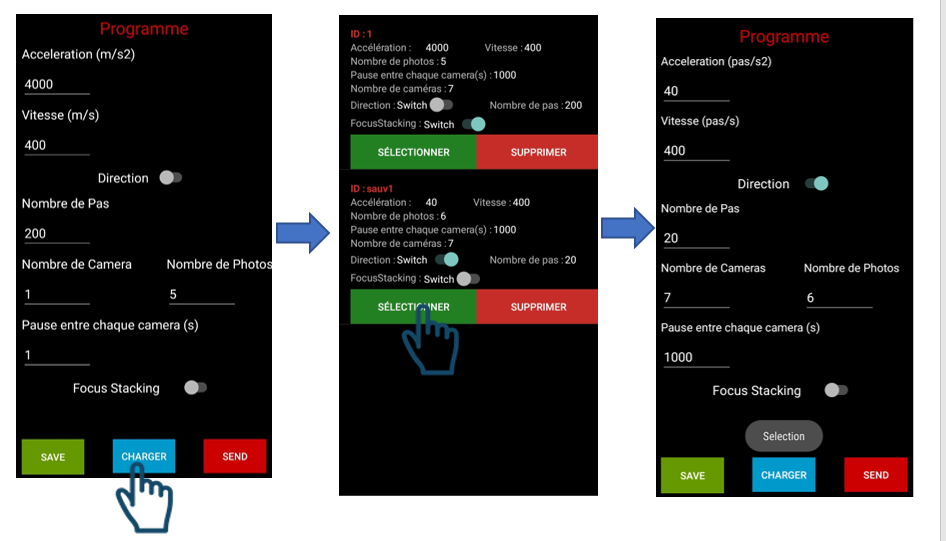
[picture p20: figure]

# IV/ Objectifs réalisés

Au terme de ce projet, nous avons réalisé tout ce qui nous avait été demandé par Monsieur Lissarague.

L’application permet d’envoyer les données au boitier de commande qui est propre au système. Nous ne passons plus par une application générique du store, ce qui permet donc à l’utilisateur d’identifier plus facilement quelles sont les informations à envoyer, sans se soucier de la trame d’envoi qui est réalisée en interne de l’application.

Concernant le système hardware, nous avons réglé les problèmes de synchronisation qui existaient et dérangeaient le bon fonctionnement par intermittence grâce à l’implémentation d’un module ESP32 plutôt que d’un Arduino. Les recherches sur les optocoupleurs nous ont également permis de pallier le problème du seul relais fonctionnant sur les trois originaux. Nous avons donc les 9 appareils qui se déclenchent lorsque le boitier de commande en donne l’ordre.

Les PCB, bien que des petits problèmes subsistent sur la version finale, sont désormais tous les deux fonctionnels et adaptés aux nouveaux composants. Le développement de la nouvelle version ayant été efficace, il a été possible de les commander en Chine pour obtenir une version plus propre et plus adaptée pour une utilisation régulière. Les problèmes observés lors du test final ont été corrigés pour une future commande.

Les objectifs ayant été remplis assez rapidement, ou en bonne voie, certaines améliorations ont rapidement été commencée. La première d’entre elle concerne l’accessibilité au code. Afin de permettre à d’autres étudiants de reprendre le code, tout a été pensé (l’utilisation de librairy, un nom cohérent pour chaque fichier et packages que l’on soit dans le code l’application ou dans le code du boitier de commande…) afin de pouvoir ajouter des nouvelles fonctionnalités facilement sans devoir remanier l’intégralité du code.

Nous nous sommes également penchés sur l’optimisation de l’application, celle-ci envoie les données, comme souhaité, au boitier de commande, mais permet également une meilleure interaction avec l’utilisateur. L’intégration d’un feedback permet à l’utilisateur de suivre exactement la prise de photo ou les rotations du moteur, et la BDD permet une facilité d’utilisation dans le cadre de prises de vue identiques d’un objet à l’autre.

Enfin, nous avons commencé à travailler sur le focus stacking, l’application l’intègre désormais dans son fonctionnement et permet de régler le moteur en fonction des paramètres de rotation souhaités, et le moteur envoie bien les ordres à un ESP32 connecté sur l’appareil photo. Le fonctionnement général est bon, il ne manque plus que le déclenchement de l’appareil photo par l’ESP32.

# V/ Limites et axes d’amélioration

Au niveau des axes d’amélioration, il faudrait sécuriser davantage l’application afin d’éviter l’envoi de mauvaises données par l’utilisateur. Pour l’instant, nous partons du principe que l’utilisateur connait le fonctionnement et ne va pas envoyer une valeur d’accélération erronée par exemple. Cependant, l’objectif pouvant être de vulgariser le système, il faudrait assurer un contrôle de chaque donnée envoyée.

Il faudrait également s’attarder sur le changement de périphériques au cours d’une session. A ce stade, l’option est affichée dans l’application, mais n’est pas fonctionnelle, il n’y a pas de possibilité de changer les périphériques sélectionnés sans devoir fermer l’application avant.

Un autre problème pouvant être corrigé mais ne posant pas de problème pour un utilisateur utilisant le système concerne l’ordre d’arrêt des périphériques. En effet, pour un bon fonctionnement du système il est important lorsque l’on souhaite utiliser le système de bien s’assurer auparavant que tous les périphériques ont bien été déconnecter. Or, si la déconnexion ne s’est pas bien faite, le programme ne fonctionnera pas car il sera coincé dans une boucle sans fin et ne permettra pas un bon fonctionnement

Le focus stacking ne permettant pas encore le déclenchement d’un appareil photo, il faudrait revoir les PCB afin d’identifier l’erreur conduisant à ce problème.

Enfin, il pourrait être intéressant, pour limiter les câbles, de s’attarder sur l’existence de déclenchement à distance de l’appareil photo, ce qui pourrait rendre le dispositif encore plus ergonomique.

# Conclusion

Pour conclure, les objectifs principaux ont été remplis. La table rotative fonctionne désormais grâce à l’application et une meilleure synchronisation nous permet de ne plus avoir de dysfonctionnement au cours d’une prise de vue.

Au-delà de cela, nous avons réussi à aborder certains axes d’amélioration qui pourraient être terminés dans le futur mais dont la base a déjà été posée.

Ce projet a nécessité en sus des capacités techniques, un moyen de visualiser comment l’expliquer pour pouvoir créer un mode d’emploi pour qu’il soit réutilisable.

Nous sommes satisfaits du résultat final sur l’aspect programmation et également sur l’aspect humain et gestion de projet, puisqu’un véritable dialogue a pu être créé avec Monsieur Lissarague. Ce projet nous a également permis de comprendre un projet dans sa globalité en passant d’une partie hardware à une partie software, ce qui est une expérience très enrichissante.

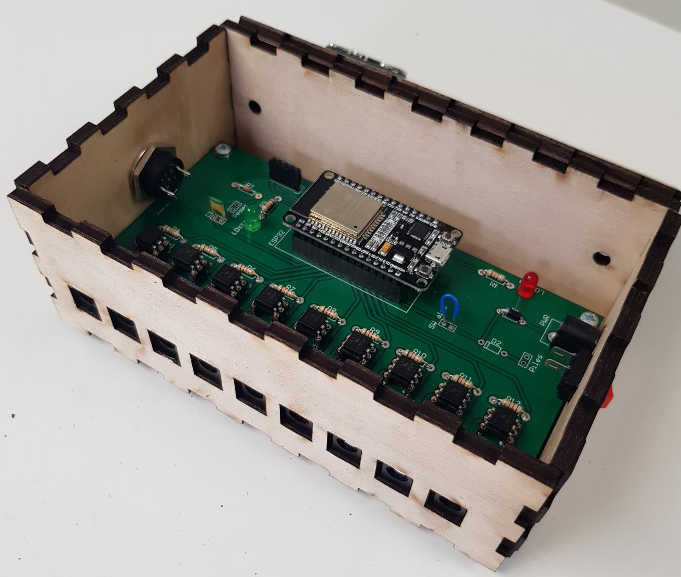
[picture p21: figure]
