LouisMalbranque/Table-Rotative/Objectifs projets.docx

Hardxare + software

Objectifs principaux :

- Table exploitable et fonctionnelle
- Partie hardware finalisée
- Appli fonctionnelle
- PCB en Chine => pas d’oxydation
- ESP 32 : mise en place d’un nouveau boitier
- Tour en continu
- Régler le problème sur les relais
- Délai sur les relais : temps de pause en fonction du nombre d’appareils

Objectifs secondaires :

- Option annexes
- Touches magnétoscope
- Appareils photos IR (dernière) : déclencher en différé + longueur d’ondes infrarouge.
- Voir pour remplacer relai avec transistors
- NEMA23
