LouisMalbranque/Table-Rotative/Modele-3D/Boitier_commande/Assem.SLDASM

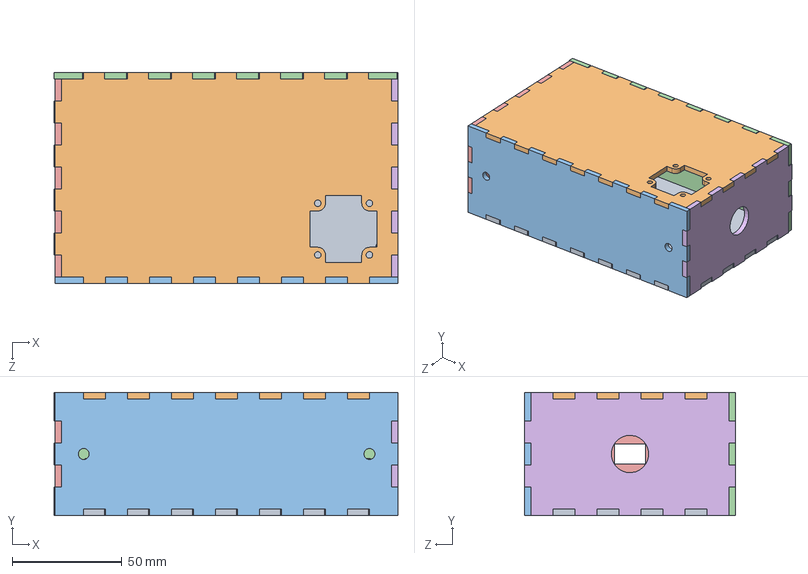
[picture p22: CAD file, 2019-04-25]
Modele-3D/Boitier_commande/Assem.SLDASM
156.5 x 56.0 x 96.0 mm
piece_basse
piece_haute
piece_avant
piece_arriere
piece_gauche
piece_droite
