LouisMalbranque/Table-Rotative/Modele-3D/Boitier_commande/piece_avant.SLDPRT

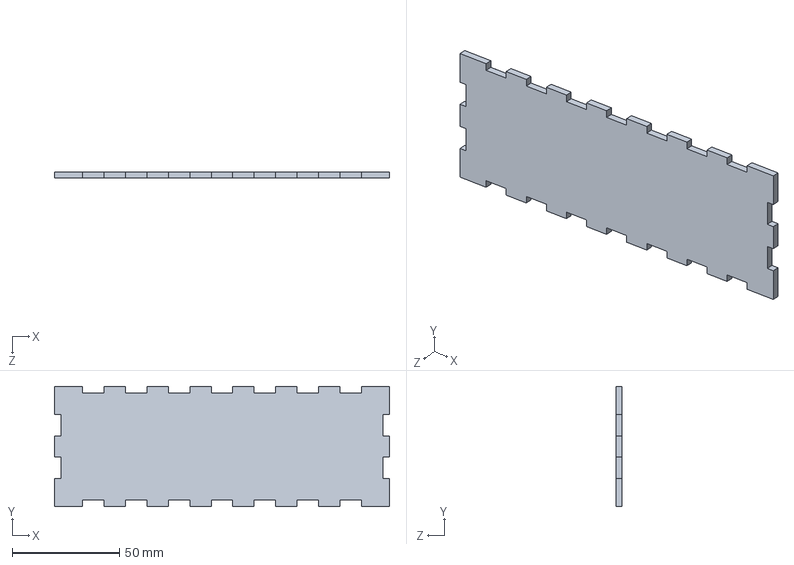
[picture p23: CAD file, 2019-04-25]
Modele-3D/Boitier_commande/piece_avant.SLDPRT
156.0 x 56.0 x 3.00 mm
