LouisMalbranque/Table-Rotative/Modele-3D/Boitier_commande/piece_basse.SLDPRT

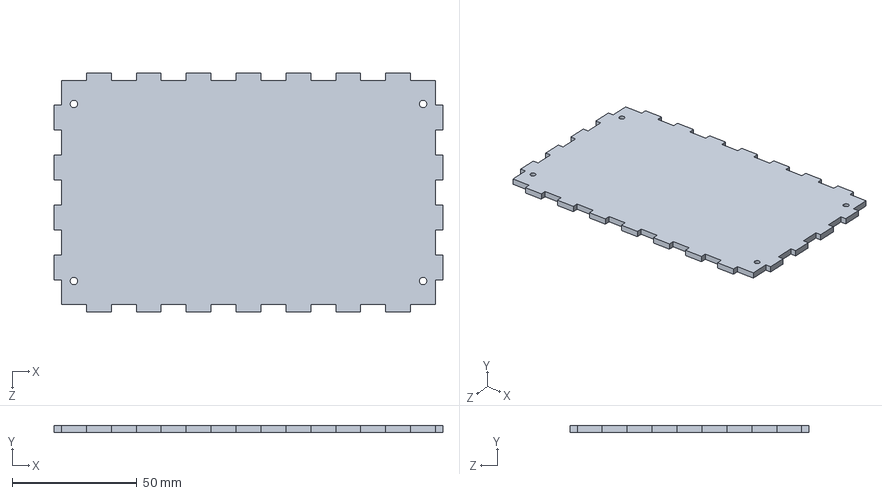
[picture p24: CAD file, 2019-04-25]
Modele-3D/Boitier_commande/piece_basse.SLDPRT
156.0 x 3.00 x 96.0 mm
