LouisMalbranque/Table-Rotative/Modele-3D/Boitier_commande/piece_gauche.SLDPRT

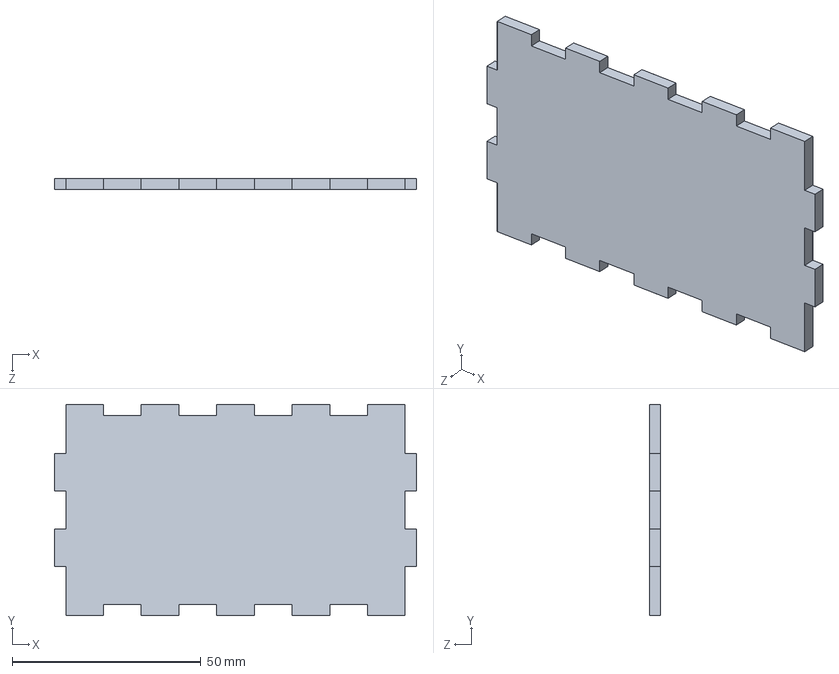
[picture p25: CAD file, 2019-04-25]
Modele-3D/Boitier_commande/piece_gauche.SLDPRT
96.0 x 56.0 x 3.00 mm
