LouisMalbranque/Table-Rotative/(list of files, cad)

Other CAD files:
Modele-3D/Boitier_commande/piece_droite.SLDPRT
Modele-3D/Boitier_commande/piece_arriere.DXF
Modele-3D/Boitier_commande/piece_avant.DXF
Modele-3D/Boitier_commande/piece_basse.DXF
Modele-3D/Boitier_commande/piece_droite.DXF
Modele-3D/Boitier_commande/piece_gauche.DXF
Modele-3D/Boitier_commande/piece_haute.DXF
