LouisMalbranque/Table-Rotative/(list of files, drawings)

Other design files:
hardware/Boitier_Commande/boitier_commande.PcbDoc
hardware/Boitier_Commande/Boitier_Commande.PrjPcb
hardware/Boitier_Commande/boitier_commande.SchDoc
hardware/Boitier_Commande/History/boitier_commande/boitier_commande.~(22).SchDoc
hardware/Boitier_Commande/librairie/4N26.PcbLib
hardware/Boitier_Commande/librairie/ESP32.pcblib
hardware/Boitier_Commande/librairie/ESP32.schlib
hardware/Boitier_Commande/librairie/NRF24.PcbLib
hardware/Boitier_Commande/librairie/NRF24.SchLib
hardware/Boitier_Commande/librairie/Optocoupleur.SchLib
hardware/Focus_stacking/focus_stacking.PcbDoc
hardware/Focus_stacking/Focus_stacking.PrjPcb
hardware/Focus_stacking/focus_stacking.SchDoc
hardware/Moteur/moteur.PCBDOC
hardware/Moteur/Moteur.PrjPcb
hardware/Moteur/moteur.SchDoc
hardware/pcb type Isen.PCBDOC
hardware/PCB_Project/PCB_Project.PrjPcb
