LouisMalbranque/Table-Rotative/software/arduino/camera/constantes.h

#define MODE                      0 // mode de fonctionnement

#define TEMPS_PAUSE               1 // temps de pause entre les photos
#define NOMBRE_DE_FOCUS           2 // nombre de focus différents
#define PAS_ENTRE_PHOTO           3 // nombre de pas entre chaque photos

#define DIRECTION                 1 // direction de rotation
#define NOMBRE_DE_PAS             2 // nombre de pas à faire

#define PIN_DIR                   25 // pin de direction
#define PIN_STEP                  26 // pin de nombre de pas

#define PIN_APPAREIL              32 // pin de commande de l'appareil

#define LED                       15 // pin de commande de la LED
