LouisMalbranque/Table-Rotative/software/arduino/plateau/constantes.h

#define ACCELERATION              0
#define VITESSE                   1
#define DIRECTION                 2
#define CHOIX_ROTATION            3
#define NOMBRE_DE_PAS             4
#define TEMPS_DE_ROTATION         4


#define MAXIMUM_NUMBER_OF_VALUES  5

#define PIN_DIR                   25
#define PIN_STEP                  26

#define LED                       15
