LouisMalbranque/Table-Rotative/(commit log)

2019-03-19 Ajout de soft
    gestion du bluetooth, de l'ecran LCD et des relays
2019-03-19 Words de gestion objectifs et trame
2019-03-19 ajout de la gestion du NRF et d'un
2019-03-19 ajout code plateau
    la trame moteur n'est pas implémentée
2019-03-21 bugfix
    commande du moteur dans le plateau
    envoie/reception de données
    [bloc_commande.ino, bluetooth.cpp, bluetooth.h, moteur.cpp, moteur.h, nrf.h, plateau.ino]
2019-03-21 bugfix plateau
2019-03-22 fonctionnel pour les 2 modes
    0,0,2,1000,3,3000,400,360,-1,-1 -> avec photos
    1,0,-1,-1,-1,3000,400,360,-1,5000 -> 5 secondes
    1,0,-1,-1,-1,3000,400,360,1,-1 -> 1 tour de 360 pas
2019-03-22 démarrage du projet android
    tentative de connexion bluetooth (pas fini)
2019-03-26 redesign page de connexion
2019-03-28 démarrage pcb boitier de commande
    [Boitier_Commande.PrjPcb, ESP32.pcblib, ESP32.schlib, Jack Alim.PcbLib, Jack Alim.SchLib, NRF24.PcbLib, NRF24.SchLib, boitier_commande.PcbDoc]
2019-03-28 fin du schematic + pcb
    [4N26.PcbLib, Boitier_Commande.PrjPcb, Optocoupleur.SchLib, boitier_commande.PcbDoc, boitier_commande.SchDoc]
2019-03-29 fin du pcb boitier de commande ISEN
    [boitier_commande.PcbDoc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]
2019-04-01 solidworks + ESP32
    [boite.SLDASM, coté_droit.SLDPRT, coté_gauche.SLDPRT, plaque_arrière.SLDPRT, plaque_avant.SLDPRT, plaque_bas.SLDPRT]
2019-04-02 Solidworks+plateau ESP32
    [boite.SLDASM, coté_droit.SLDPRT, coté_gauche.SLDPRT, plaque_avant.SLDPRT, plaque_bas.SLDPRT]
2019-04-02 modif plateau final
2019-04-02 boite solidworks
    [boite.SLDASM, coté_droit.SLDPRT, coté_gauche.SLDPRT, plaque_arrière.SLDPRT, plaque_avant.SLDPRT, plaque_bas.SLDPRT, plaque_haute.SLDPRT]
2019-04-04 début debug hard
    [boitier_commande.PcbDoc, boitier_commande.SchDoc]
2019-04-05 démarrage pcb chine
    [Boitier_Commande.PrjPcb, Jack Alim.PcbLib, boitier_commande.PcbDoc, boitier_commande.SchDoc, boitier_commande.~(22).SchDoc]
2019-04-06 pcb boitier commande + solidworks
    [boitier_commande.PcbDoc, boitier_commande.SchDoc]
2019-04-06 ajout du magneto
2019-04-07 ajouts d'idées et de pseudos-code
2019-04-07 Auto stash before merge of "master" and "origin/master"
    [boitier_commande.PcbDoc]
2019-04-09 led retournée boiter commande
    [Boitier_Commande.PrjPcb, accroche.SLDPRT, boite.SLDASM, boitier_commande.PcbDoc, boitier_commande.SchDoc]
2019-04-09 let's go China
    [boitier_commande.GBL, boitier_commande.GBO, boitier_commande.GBP, boitier_commande.GBS, boitier_commande.GKO, boitier_commande.GM1, boitier_commande.GTL, boitier_commande.GTO]
2019-04-09 modif code plateau
    [Boitier_Commande.PrjPcb]
2019-04-09 petit changement pcb
    [boitier_commande.PcbDoc]
2019-04-10 réécriture du bloc de commande
    gestion du multi-serveur et de la pause coté bloc de commande
2019-04-10 PCB Moteur
    [ProjetMoteur.GBL, ProjetMoteur.GBO, ProjetMoteur.GBP, ProjetMoteur.GBS, ProjetMoteur.GKO, ProjetMoteur.GM1, ProjetMoteur.GTL, ProjetMoteur.GTO]
2019-04-10 déplacement PCB moteur dans le dossier hardware
    [ProjetMoteur.GBL, ProjetMoteur.GBO, ProjetMoteur.GBP, ProjetMoteur.GBS, ProjetMoteur.GKO, ProjetMoteur.GM1, ProjetMoteur.GTL, ProjetMoteur.GTO]
2019-04-11 switch fragment
2019-04-11 spinner pour switch entre les fragments
2019-04-12 PCB option focus stacking
    [PCB_Project.PrjPcb, Sheet1.PCBDOC, Sheet1.SchDoc]
2019-04-12 ajout du layout de mode programmé liste
2019-04-12 ajout du layout de mode temps réel liste
2019-04-15 modif fragments + charger bdd
2019-04-15 Ajout chargement BDD
2019-04-16 modif trame plateau
2019-04-16 encore modif a faire sur la synchro
2019-04-17 ajout lcd + debug pcb commande
    [boitier_commande.SchDoc]
2019-04-17 ajout de la selection de périphérique coté appli (l'envoie est commenté)
2019-04-17 Recup données chargement BDD
2019-04-17 changement layout + correctif button
2019-04-17 ajout de la sélection des périphériques coté bloc de commande
2019-04-19 ajout de 2 modules de focus stacking
2019-04-20 changement du doc de trame
2019-04-22 param focus
    [Boitier_Commande.PrjPcb]
2019-04-23 implémentation modules de focus stacking
2019-04-23 quasi dernier changement appli
    [boitier_commande.GBL, boitier_commande.GBS, boitier_commande.GKO, boitier_commande.GM1, boitier_commande.GTL, boitier_commande.GTO, boitier_commande.GTP, boitier_commande.GTS]
2019-04-24 Changement PCB boitier commande + code boitier commande
    [Boitier_Commande.PrjPcb, boitier_commande.PcbDoc]
2019-04-24 changement pcb_project
    [Jack Alim.PcbLib, Jack Alim.SchLib, PCB_Project.PrjPcb, Sheet1.PCBDOC, Sheet1.SchDoc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]
2019-04-25 changement code led
2019-04-25 Rectif PCB
    [Sheet1.SchDoc]
2019-04-25 modif modèle 3D
    [Assem.SLDASM, accroche.SLDPRT, boite.SLDASM, boite.dxf, coté_droit.SLDPRT, coté_gauche.SLDPRT, piece_avant.SLDPRT, piece_basse.SLDPRT]
2019-04-25 changement hardware
    [ProjetMoteur.PCBDOC, ProjetMoteur.SchDoc, ProjetMoteur.~(12).PCBDOC, Sheet1.PCBDOC, Sheet1.SchDoc]
2019-04-25 changement final + fichiers de fabrication pcb chine
    [PCB_Project.PrjPcb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]
2019-04-25 changemnet BDD
    [PCB_Project.PrjPcb, ProjetMoteur.PrjPcb]
2019-04-25 fin modème 3d + modif mineures arduino
    [Assem.SLDASM, boite.dxf, piece_arriere.DXF, piece_arriere.SLDPRT, piece_avant.DXF, piece_avant.SLDPRT, piece_basse.DXF, piece_basse.SLDPRT]
2019-04-25 derniere modif nom appli et logo + page de connexion
2019-04-25 petites modifs powerpoint
2019-04-26 modifs powerpoint
2019-04-30 commentaire de code du boitier de commande
2019-05-03 ajout de commentaires + suppressions de dossiers inutiles
2019-05-03 changement rapport en attente de photo librairy
2019-05-03 changement pcb nom
    [Focus_stacking.PrjPcb, Jack Alim.PcbLib, Jack Alim.SchLib, Moteur.PrjPcb, PCB_Project.PrjPcb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]
2019-05-03 suppression de fichiers inutiles et ajout du mode d'emploie
    [boitier_commande.GBL, boitier_commande.GBO, boitier_commande.GBP, boitier_commande.GBS, boitier_commande.GKO, boitier_commande.GM1, boitier_commande.GTL, boitier_commande.GTO]
2019-05-03 changement altium
    [Boitier_Commande.PrjPcb, Focus_stacking.PrjPcb, Moteur.PrjPcb]
2019-05-07 baudrate 9600 boitier de commande
2019-05-13 nom périph
    [app.xml, module_app.xml]
